kevinhoang1505/Medicine_Box/README.md

# Medicine_Box
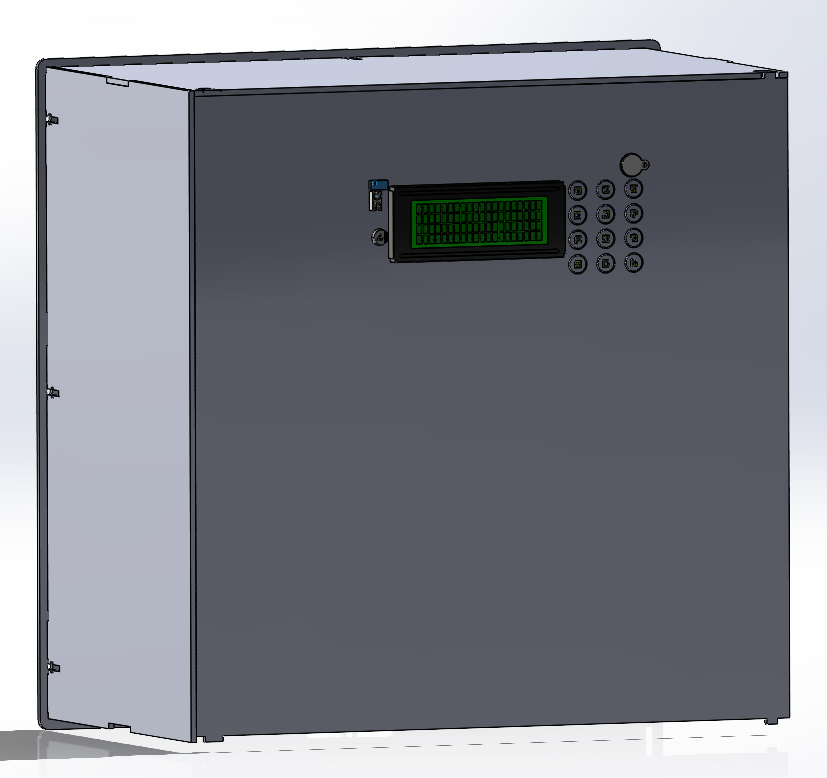
[picture p1: 3D Box/3D_View.png]
