kevinhoang1505/Medicine_Box/Keypad_Controller/PCB Design/bottom.png

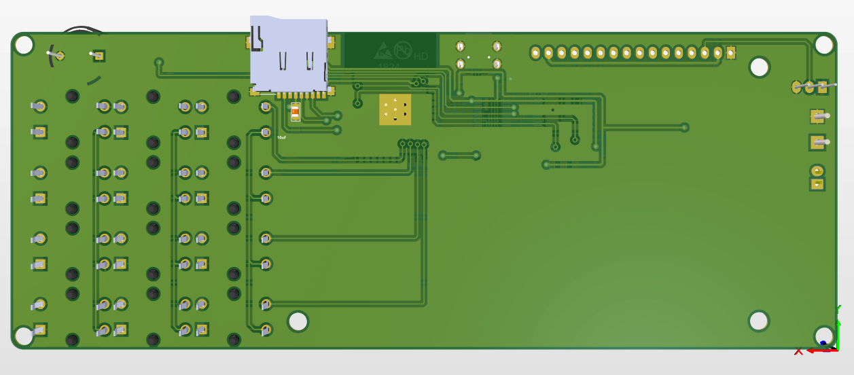
Keypad_Controller/PCB Design/bottom.png
