kevinhoang1505/Medicine_Box/Keypad_Controller/PCB Design/top.png

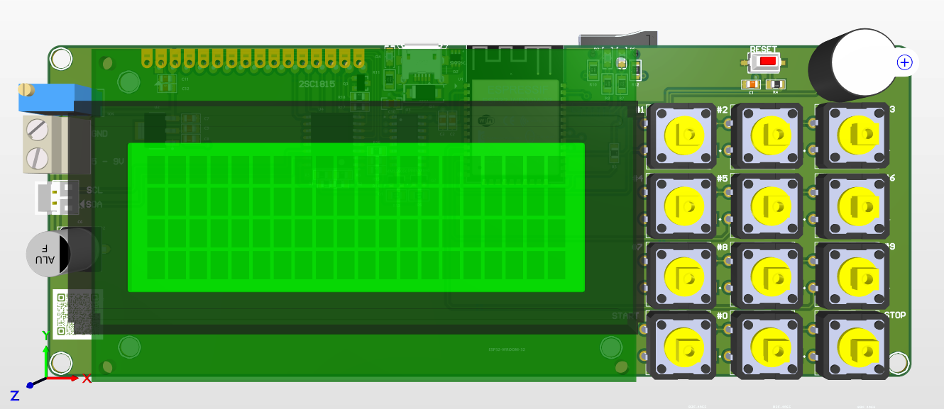
Keypad_Controller/PCB Design/top.png
