kevinhoang1505/Medicine_Box/Medicine Machine - System Design - 2.png

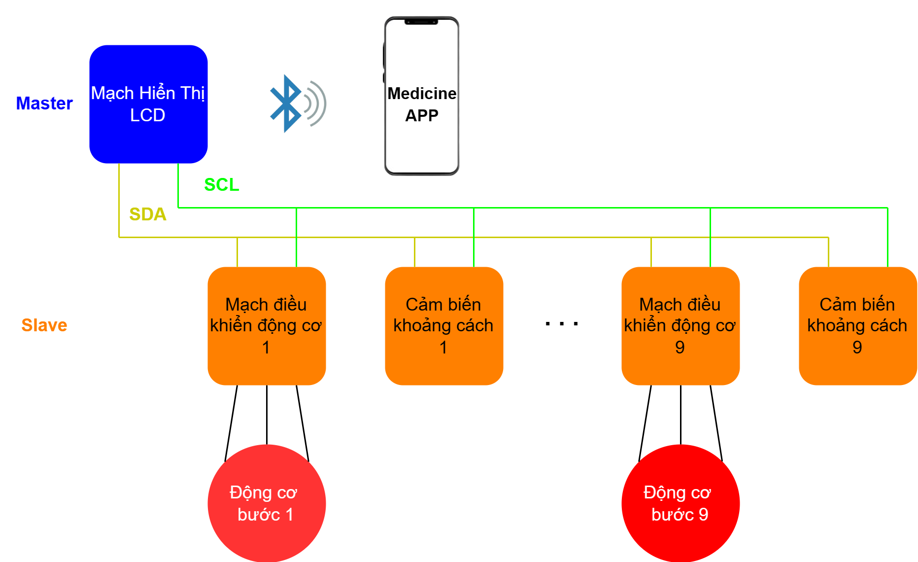
Medicine Machine - System Design - 2.png
