kevinhoang1505/Medicine_Box/Stepper_Motor_Controller/PCB Design/Top-PCB.png

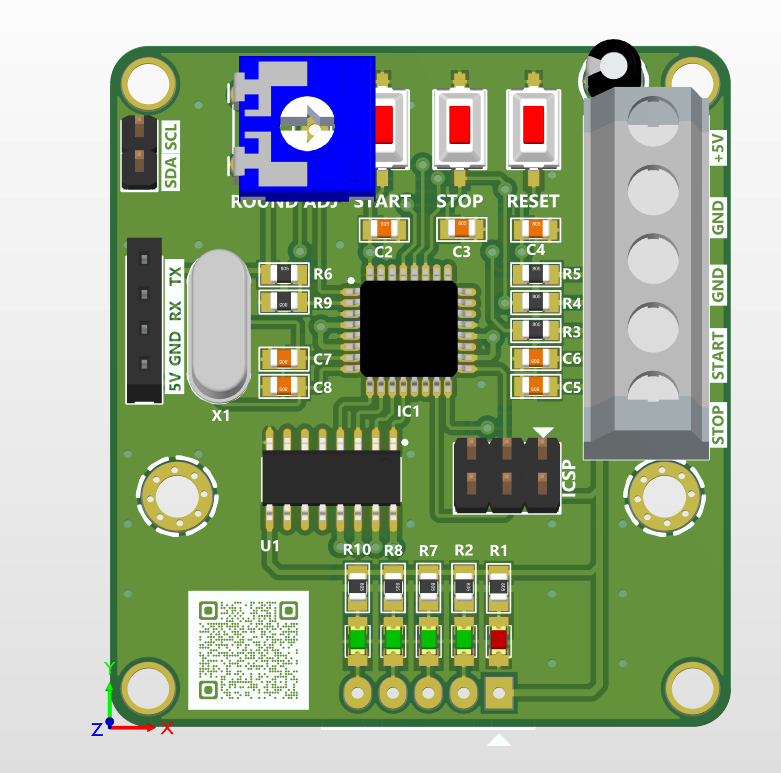
Stepper_Motor_Controller/PCB Design/Top-PCB.png
