kevinhoang1505/Medicine_Box/Stepper_Motor_Controller/PCB Design/Stepper_Motor_Controller_BOM.xlsx

Comment | Description | Designator | Footprint | Quantity
100uF |  | C1 | CA-ALU-2.54 | 1
100nF |  | C2, C3, C4, C6 | CN-SMD-0805 | 4
10uF |  | C5 | CN-SMD-0805 | 1
22pF |  | C7, C8 | CN-SMD-0805 | 2
ATmega8 | 8-Bit AVR Microcontroller with 8K Bytes of In-System Programmable Flash Memory | IC1 | TQFP32 | 1
KF5 |  | J1 | KF5-5 | 1
MOTOR | Header IDC, 5 x 1 Pin Vertical 2.54mm Pitch (Non-Boxed, Male) | J2 | Header5 | 1
UART | WR-PHD 2.54 mm Angled Socket Header | J3 | JP4-C1T | 1
ICSP | WR-PHD 2.54 mm Dual Socket Header | J4 | JP3-D2T | 1
I2C | WR-PHD 2.54 mm Angled Socket Header | J5 | JP2-D1T | 1
LED |  | LED1 | LED-0805-Red | 1
LED |  | LED2, LED3, LED4, LED5 | LED-0805-Green | 4
3K3 | Resistor | R1, R2, R7, R8, R10 | RES-SMD-0805 | 5
10K | Resistor | R3, R4, R5, R6 | RES-SMD-0805 | 4
0R | Resistor | R9 | RES-SMD-0805 | 1
SW | Switch button 2 pin | SW1, SW2, SW3 | SW1-SMD | 3
ULN2003A | High-Voltage, High-Current Darlington Array | U1 | SO16 | 1
10K | Var Resistor | VR1 | VR-S2 | 1
16Mhz | Crystal, 32.768 KHz, -40 to 85 degC, 3.2 x 1.5 x 0.9 mm SMD | X1 | XT2 | 1
