kevinhoang1505/Medicine_Box/Keypad_Controller/PCB Design/Keypad_Controller_BOM.xlsx

Comment | Description | Designator | Quantity | Giá tiền | Link
Tụ dán 100nF |  | C1, C5 | 2 | 1900 | https://www.thegioiic.com/tu-gom-0805-100nf-0-1uf-50v
Tụ dán 22pF |  | C2, C3 | 2 | 2700 | https://www.thegioiic.com/tu-gom-0805-22pf-100v
Tụ dán 10uF |  | C4 | 1 | 4000 | https://www.thegioiic.com/tu-gom-0805-10uf-25v
Domino 4 |  | J1 | 1 | 2000 | https://www.thegioiic.com/kf301-4-v-domino-4-chan-thang-5-08mm-300v-10a-han-pcb
Rào đực | WR-PHD 2.54 mm Dual Socket Header | J2 | 1 | 1400 | https://www.thegioiic.com/hang-rao-duc-don-2-54mm-40-chan-1-hang-cao-11-2mm-xuyen-lo-loai-tot
Rào cái ngang | WR-PHD 2.54 mm Angled Socket Header | J3 | 1 | 900 | https://www.thegioiic.com/hang-rao-duc-don-2-54mm-40-chan-cong-1-hang-cao-6mm-xuyen-lo
LCD 1602 | LCD dipslay 16 char, 2 line | LCD1 | 1 | Đã mua | Đã mua
Buzzer 5V | Loudspeaker | LS1 | 1 | 2500 | https://www.thegioiic.com/1209-dip-buzzer-12x9mm-93db
Điện trở dán 10K | Resistor | R1 | 1 | 2400 | https://www.thegioiic.com/dien-tro-10-kohm-0805-1
Điện trở dán 4.7K | Resistor | R2, R3, R4, R5 | 4 | 2400 | https://www.thegioiic.com/dien-tro-4-7-kohm-0805-1-
Nút nhấn B3F-4055 |  | S1, S2, S3, S4, S5, S6, S7, S8, S9, S10, S11 | 11 | 30000 | https://www.thegioiic.com/b3f-4055-nut-nhan-12x12mm-cao-7-3mm-4-chan-xuyen-lo-omron
Switch DIP 1 Pin | Switch button 2 pin | SW1 | 1 | 1750 | https://www.thegioiic.com/cong-tac-1-bit-dip-switch-xuyen-lo-2-54mm-mau-do
ATmega168A-AU | 8-bit AVR Microcontroller, 16KB Flash, 512 Bytes EEPROM, 1KB SRAM, 32-pin TQFP, Industrial Grade (-40°C to 85°C) | U1 | 1 | 75000 | https://www.thegioiic.com/atmega168pa-au-8bit-avr-microcontroller-20mhz-16kb-flash-32-pin-tqfp
Biến trở vuông 10K | Var Resistor | VR1 | 1 | 2000 | https://www.thegioiic.com/3296w-103-bien-tro-10-kohm-3-chan-chinh-top-0-5w
Thạch anh 16Mhz | Crystal, 32.768 KHz, -40 to 85 degC, 3.2 x 1.5 x 0.9 mm SMD | X1 | 1 | 1700 | https://www.thegioiic.com/products?search=Th%E1%BA%A1ch+anh+16Mhz&stock=1
Nắp nút nhấn xanh lá |  |  | 10 | 4000 | https://www.thegioiic.com/nap-nut-nhan-tactile-12x12mm-cao-3-6mm-dau-tron-mau-xanh-la
Nắp nút nhấn xanh đỏ |  |  | 2 | 800
 |  |  | Tổng | 135450
