kevinhoang1505/Medicine_Box/3D Box/MedicineBox/Base.DXF

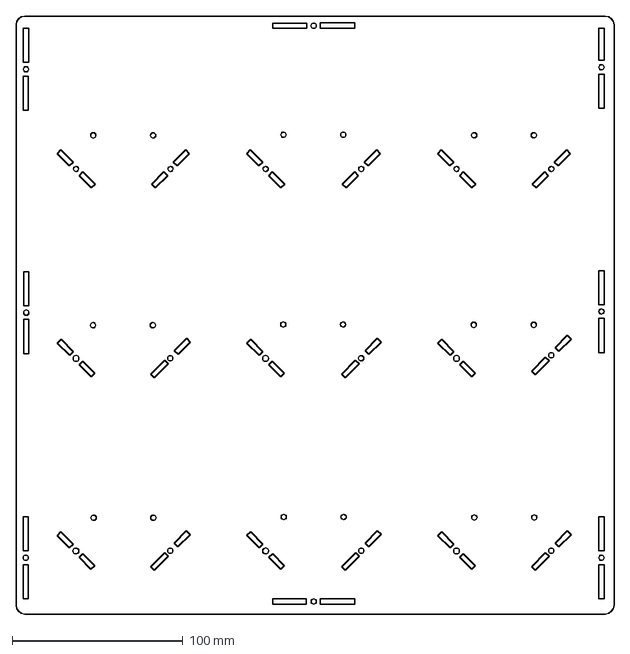
[picture p7: CAD file, 2023-08-04]
3D Box/MedicineBox/Base.DXF
350.0 x 350.0 mm
