kevinhoang1505/Medicine_Box/3D Box/MedicineBox3/3D/MedicineBox3-1.STEP

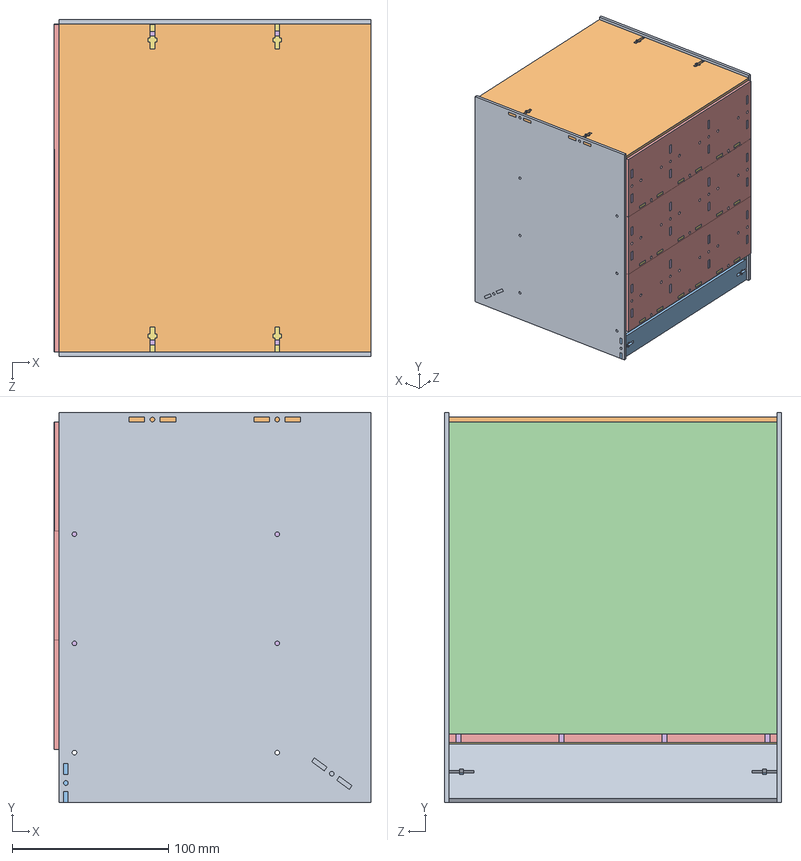
[picture p8: CAD file, 2024-01-08]
3D Box/MedicineBox3/3D/MedicineBox3-1.STEP
203.0 x 250.0 x 216.0 mm
Box-part-1 x 2
Box-part-2
Box-part-4
Box-part-6
Slot-part-1 x 3
Slot-part-2 x 12
Slot-part-3 x 3
Box-part-3 x 6
Box-part-5
