kevinhoang1505/Medicine_Box/3D Box/MedicineBox3/Drawing/part-5.DXF

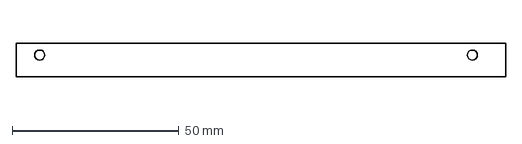
[picture p9: CAD file, 2024-01-08]
3D Box/MedicineBox3/Drawing/part-5.DXF
147.0 x 10.0 mm
