kevinhoang1505/Medicine_Box/3D Box/MedicineBox/Part5.DXF

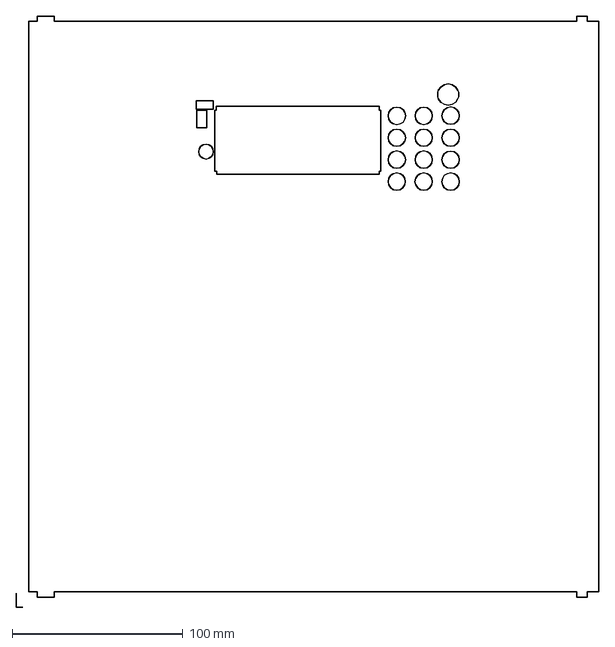
[picture p10: CAD file, 2023-08-04]
3D Box/MedicineBox/Part5.DXF
341.1 x 345.8 mm
