kevinhoang1505/Medicine_Box/3D Box/MedicineBox3/Drawing/part-11.DXF

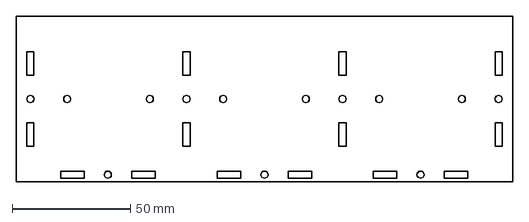
[picture p11: CAD file, 2024-01-08]
3D Box/MedicineBox3/Drawing/part-11.DXF
210.0 x 70.0 mm
