kevinhoang1505/Medicine_Box/3D Box/MedicineBox/Part1.DXF

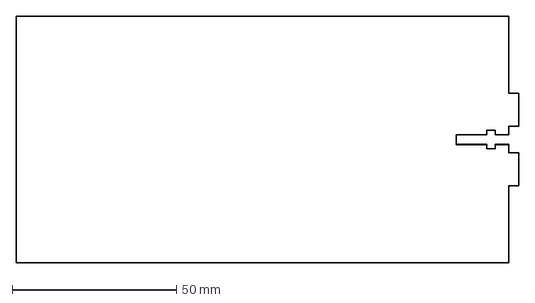
[picture p12: CAD file, 2023-08-04]
3D Box/MedicineBox/Part1.DXF
153.0 x 75.1 mm
