kevinhoang1505/Medicine_Box/3D Box/MedicineBox3/Drawing/part-1.DXF

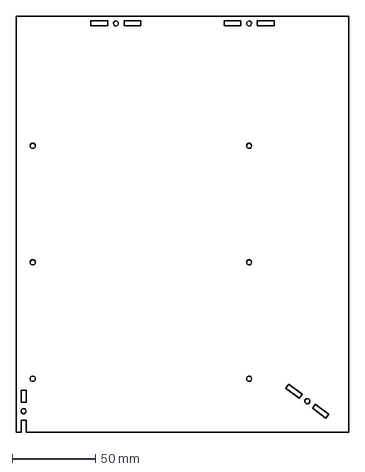
[picture p13: CAD file, 2024-01-08]
3D Box/MedicineBox3/Drawing/part-1.DXF
200.0 x 250.0 mm
