kevinhoang1505/Medicine_Box/3D Box/MedicineBox/Part3.DXF

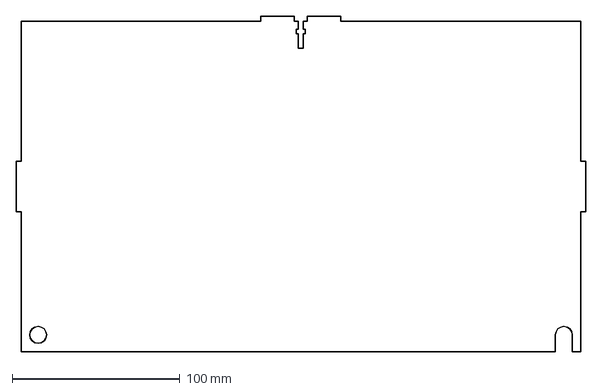
[picture p14: CAD file, 2023-08-04]
3D Box/MedicineBox/Part3.DXF
339.7 x 200.0 mm
