kevinhoang1505/Medicine_Box/3D Box/MedicineBox3/Drawing/part-13.DXF

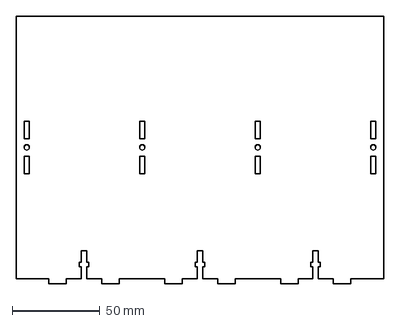
[picture p15: CAD file, 2024-01-08]
3D Box/MedicineBox3/Drawing/part-13.DXF
210.0 x 153.0 mm
