kevinhoang1505/Medicine_Box/3D Box/MedicineBox/Part2.DXF

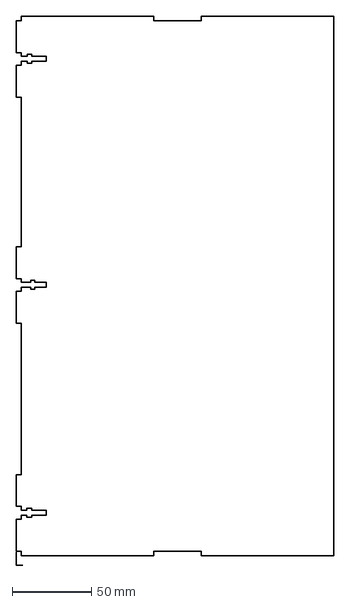
[picture p16: CAD file, 2023-08-04]
3D Box/MedicineBox/Part2.DXF
200.0 x 345.8 mm
