kevinhoang1505/Medicine_Box/3D Box/MedicineBox3/Drawing/part-2.DXF

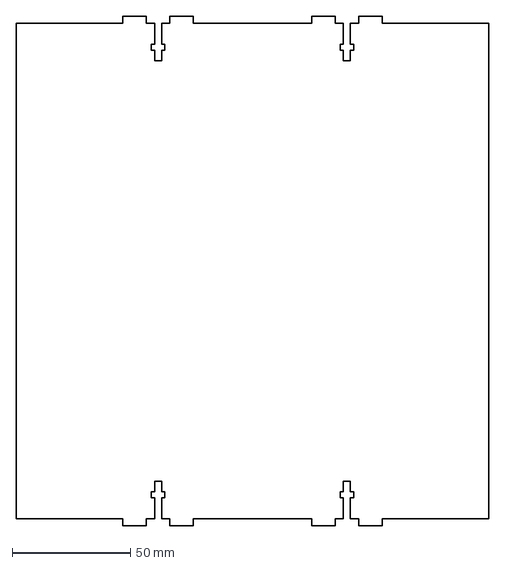
[picture p17: CAD file, 2024-01-08]
3D Box/MedicineBox3/Drawing/part-2.DXF
200.0 x 216.0 mm
