kevinhoang1505/Medicine_Box/3D Box/MedicineBox/Part4.DXF

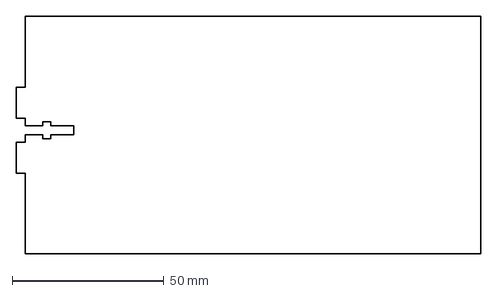
[picture p18: CAD file, 2023-08-04]
3D Box/MedicineBox/Part4.DXF
153.0 x 78.2 mm
