kevinhoang1505/Medicine_Box/3D Box/MedicineBox3/Drawing/part-3.DXF

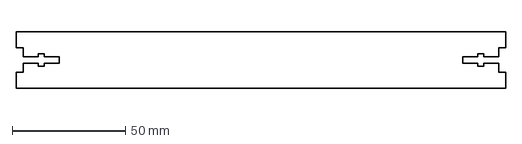
[picture p19: CAD file, 2024-01-08]
3D Box/MedicineBox3/Drawing/part-3.DXF
216.0 x 25.0 mm
