kevinhoang1505/Medicine_Box/3D Box/MedicineBox3/Drawing/part-kinh.DXF

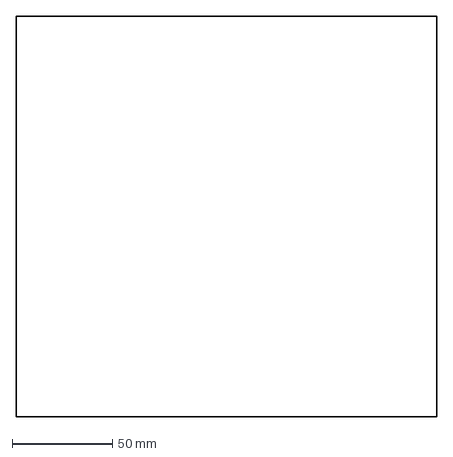
[picture p20: CAD file, 2024-01-08]
3D Box/MedicineBox3/Drawing/part-kinh.DXF
210.0 x 200.0 mm
