kevinhoang1505/Medicine_Box/3D Box/MedicineBox3/Drawing/part-4.DXF

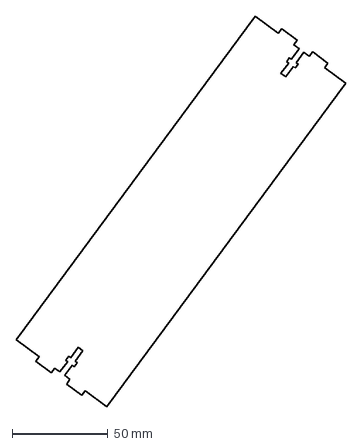
[picture p21: CAD file, 2024-01-08]
3D Box/MedicineBox3/Drawing/part-4.DXF
172.2 x 203.8 mm
