kevinhoang1505/Medicine_Box/3D Box/MedicineBox3/Drawing/part-12.DXF

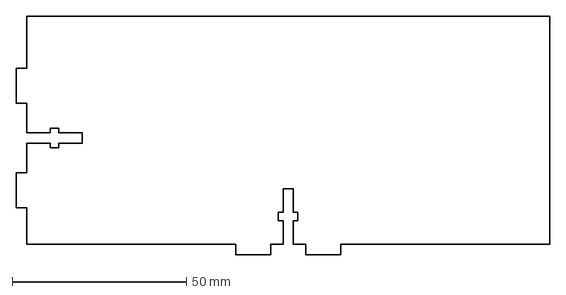
[picture p22: CAD file, 2024-01-08]
3D Box/MedicineBox3/Drawing/part-12.DXF
153.0 x 68.5 mm
