kevinhoang1505/Medicine_Box/Keypad_Controller/PCB Design/Keypad_Controller_Schematic.pdf

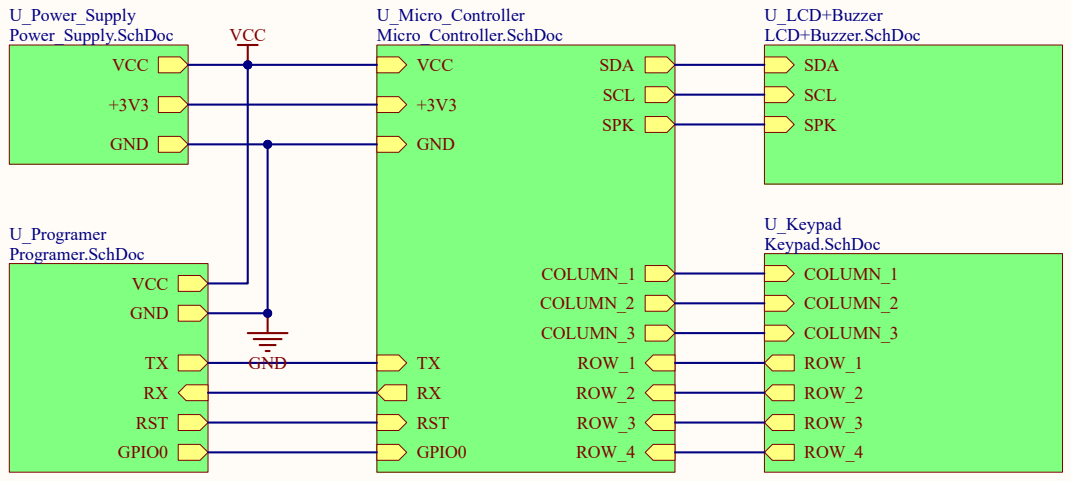
[picture p23: page 1]
Title; Size; Number; Revision; Date:; Sheet of; File:; D:\Workspace\..\Schematic.SchDoc; Drawn By:; COLUMN_1; COLUMN_2; COLUMN_3; ROW_1; ROW_2; ROW_3; ROW_4; U_Keypad Keypad.SchDoc; VCC; GND; U_Power_Supply Power_Supply.SchDoc; RST; GPIO0; U_Programer Programer.SchDoc; SDA; SCL; SPK; U_Micro_Controller Micro_Controller.SchDoc; U_LCD+Buzzer LCD+Buzzer.SchDoc; KΞVIN HOΛNG; CONTROLLER PANEL

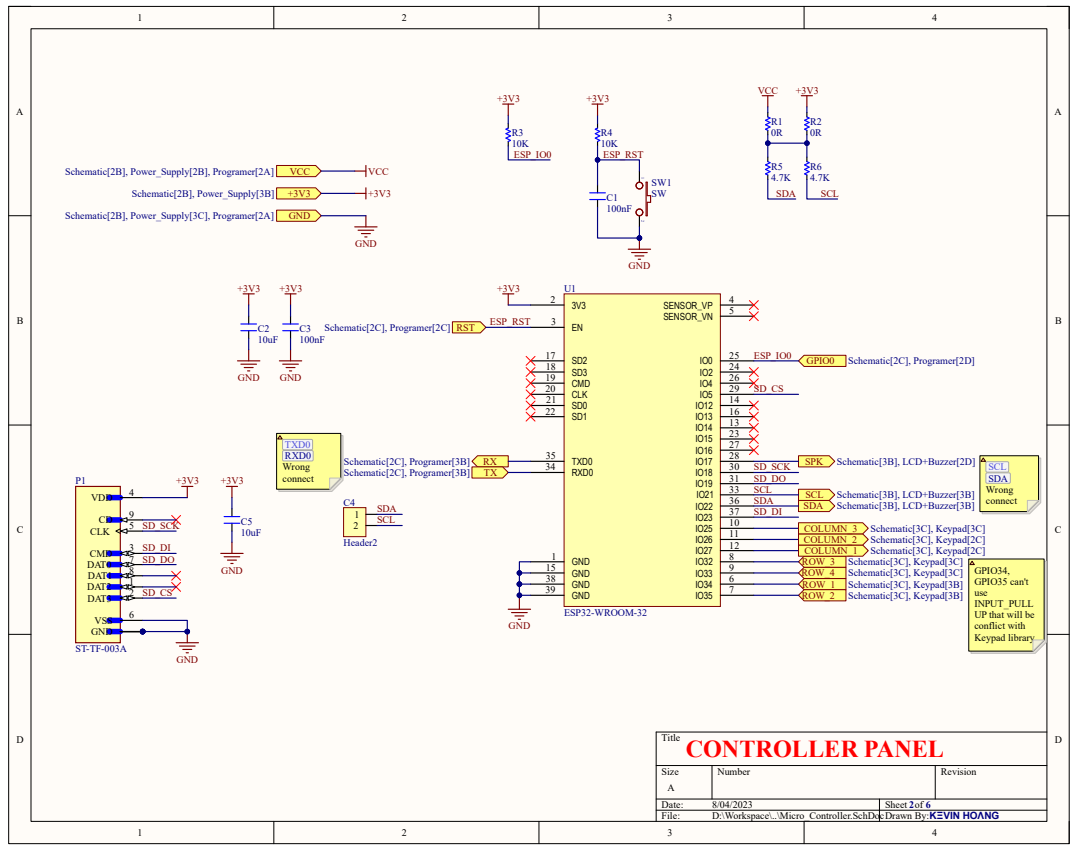
[picture p24: page 2]

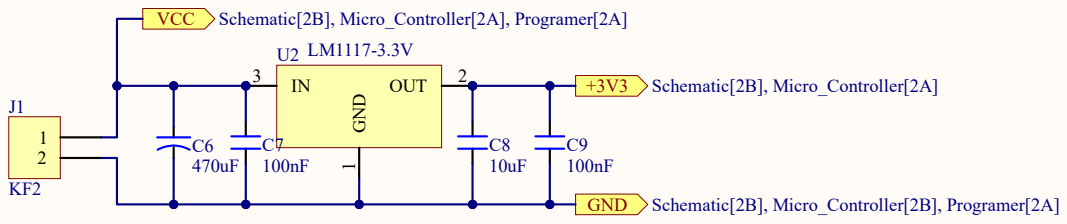
[picture p25: page 3]
Title; Size; Number; Revision; File:; D:\Workspace\..\Power_Supply.SchDoc; Drawn By: GND; OUT; +3V3 Schematic[2B], Micro_Controller[2A]; CONTROLLER PANEL

VCC Schematic[2B], Micro_Controller[2A], Programer[2A]

GND Schematic[2B], Micro_Controller[2B], Programer[2A]

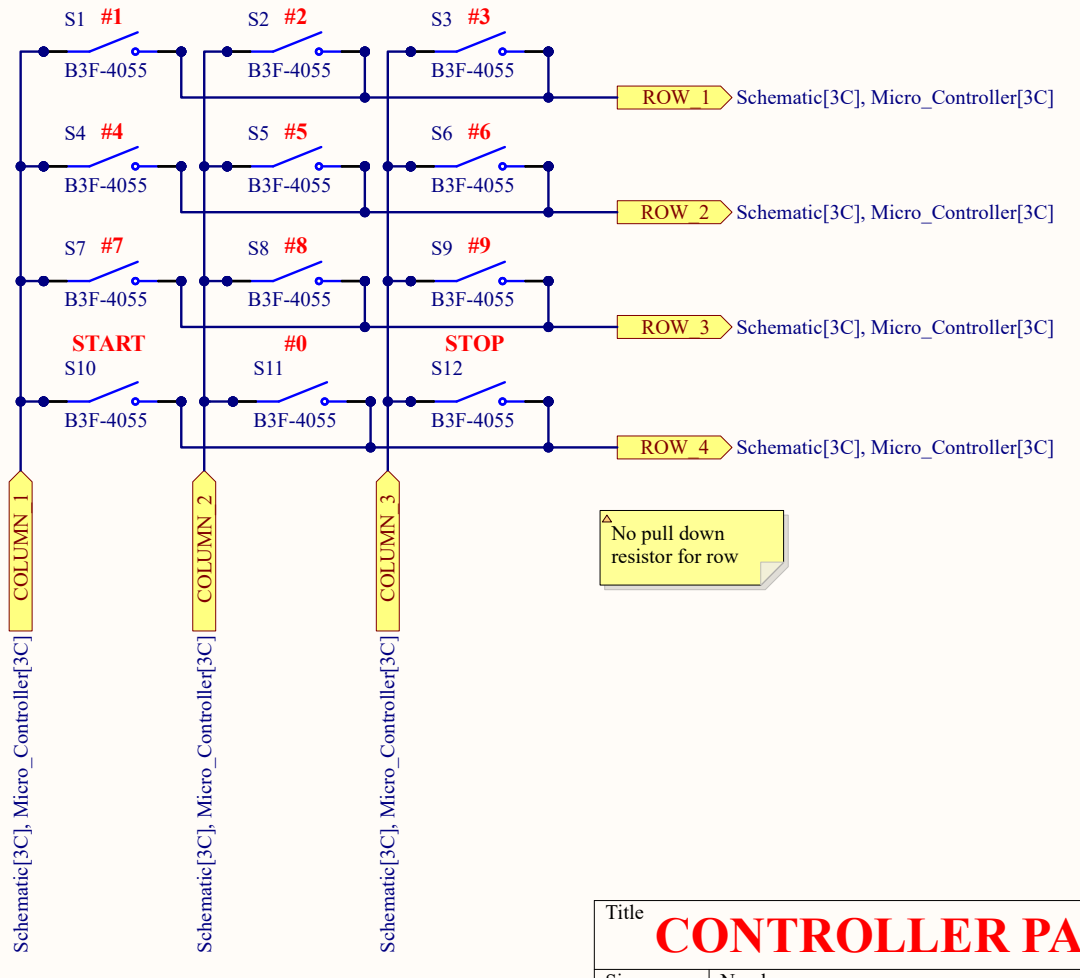
[picture p26: page 4]
Title; Size; Number; Revision; File:; D:\Workspace\..\Keypad.SchDoc; Drawn By:; #9 COLUMN_1 Schematic[3C], Micro_Controller[3C]; COLUMN_2 Schematic[3C], Micro_Controller[3C]; COLUMN_3 Schematic[3C], Micro_Controller[3C]; ROW_1 Schematic[3C], Micro_Controller[3C]; ROW_2 Schematic[3C], Micro_Controller[3C]; ROW_3 Schematic[3C], Micro_Controller[3C]; START; ROW_4; Schematic[3C], Micro_Controller[3C]; STOP; CONTROLLER PANEL

No pull down
resistor for row

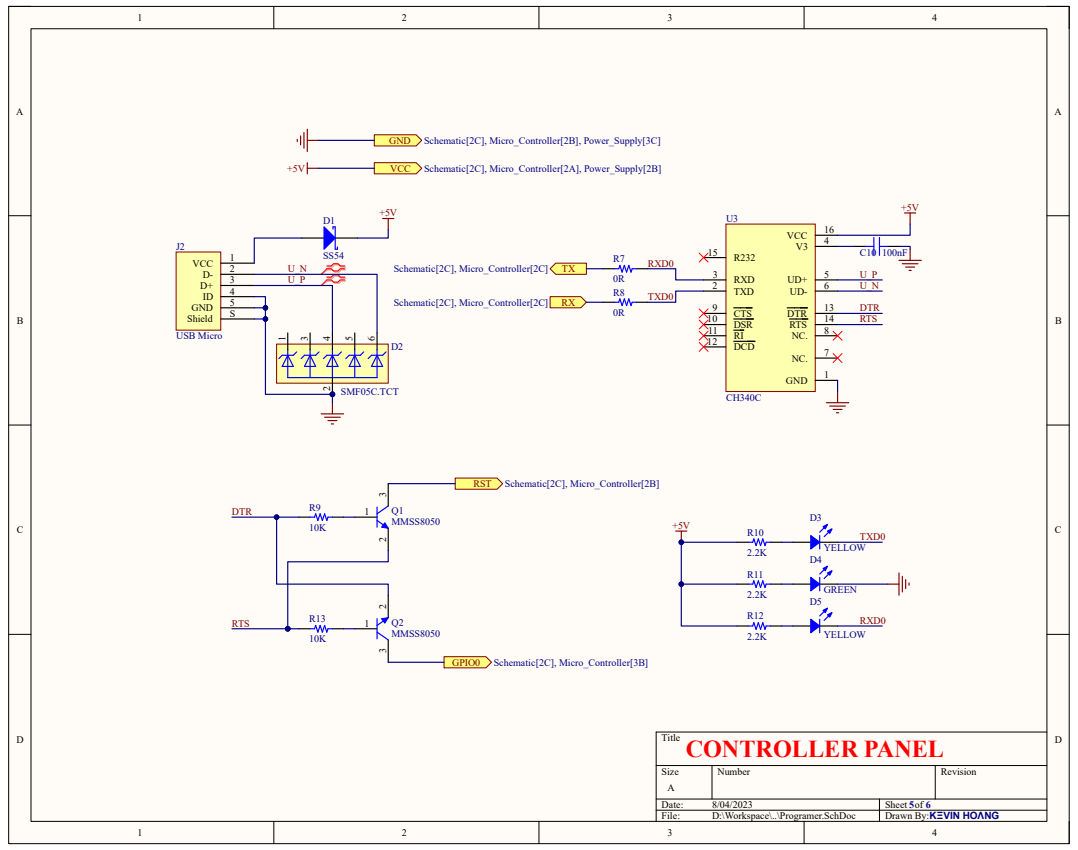
[picture p27: page 5]

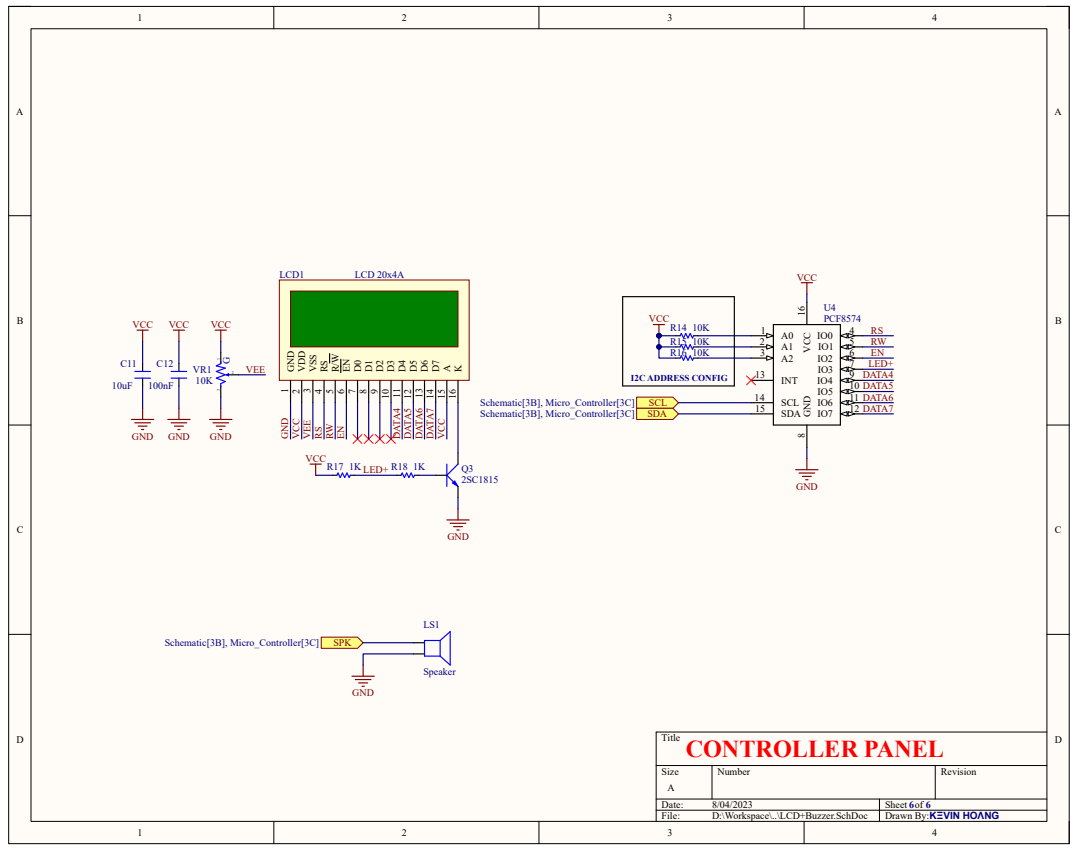
[picture p28: page 6]
