kevinhoang1505/Medicine_Box/Stepper_Motor_Controller/PCB Design/Stepper_Motor-Schematic.pdf

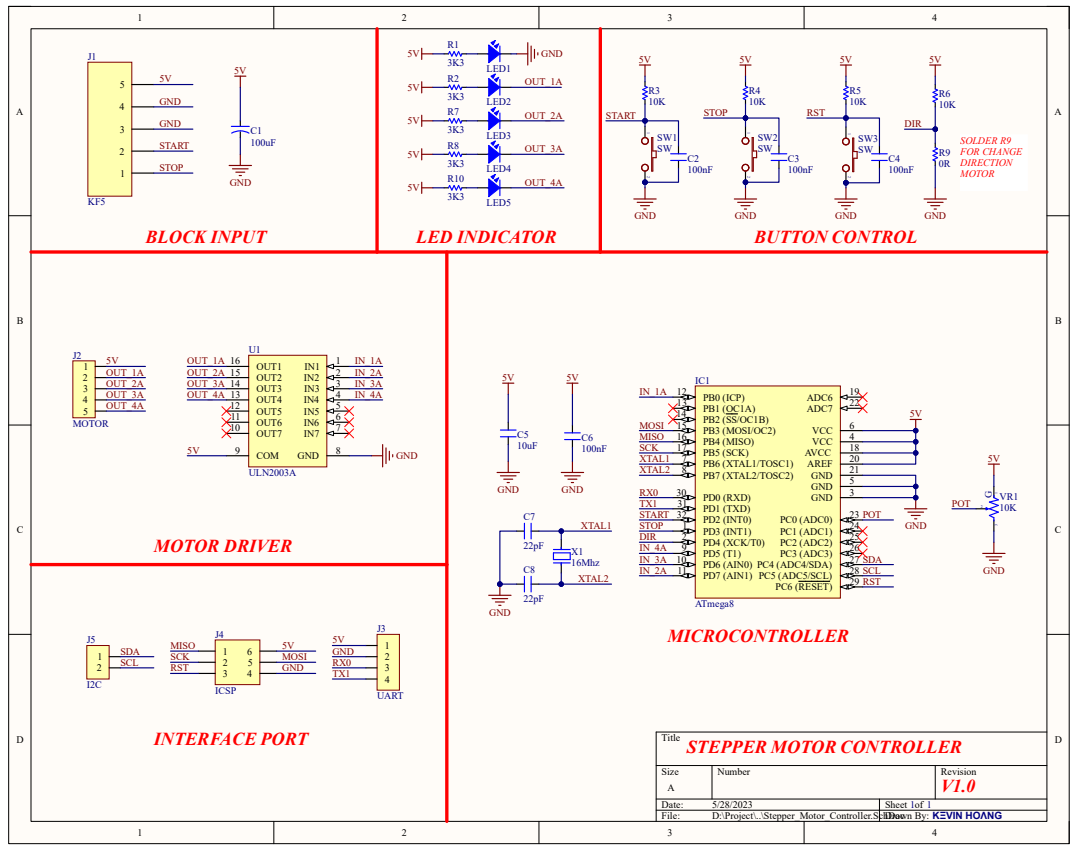
[picture p29: page 1]
