kevinhoang1505/Medicine_Box/(commit log)

2023-08-04 Upload 3D Model & Stepper_Controller & Keypad_Controller
    [Base.DXF, Keypad_Controller_BOM.xlsx, Part1.DXF, Part2.DXF, Part3.DXF, Part4.DXF, Part5.DXF]
2023-08-04 Add Stepper_Motor_Controller folder
2023-08-04 Add BOM & Schematic
    [Stepper_Motor_Controller_BOM.xlsx]
2024-01-08 update 3D Box
    [Base.DXF, Part1.DXF, Part2.DXF, Part3.DXF, Part4.DXF, Part5.DXF, part-1.DXF, part-11.DXF]
2024-01-08 change direction folder
    [part-1.DXF, part-11.DXF, part-12.DXF, part-13.DXF, part-2.DXF, part-3.DXF, part-4.DXF, part-5.DXF]
